korken89/crkbd-shockburst/bottom-plate/production/bom.csv

Designator | Footprint | Quantity | Value | LCSC Part #
_5, _4, _3, _2, | M2_Hole_TH | 5
