korken89/crkbd-shockburst/chocburst/crkbd-shockburst.kicad_pcb

## KiCad design chocburst/crkbd-shockburst.kicad_pcb (2023-09-01)

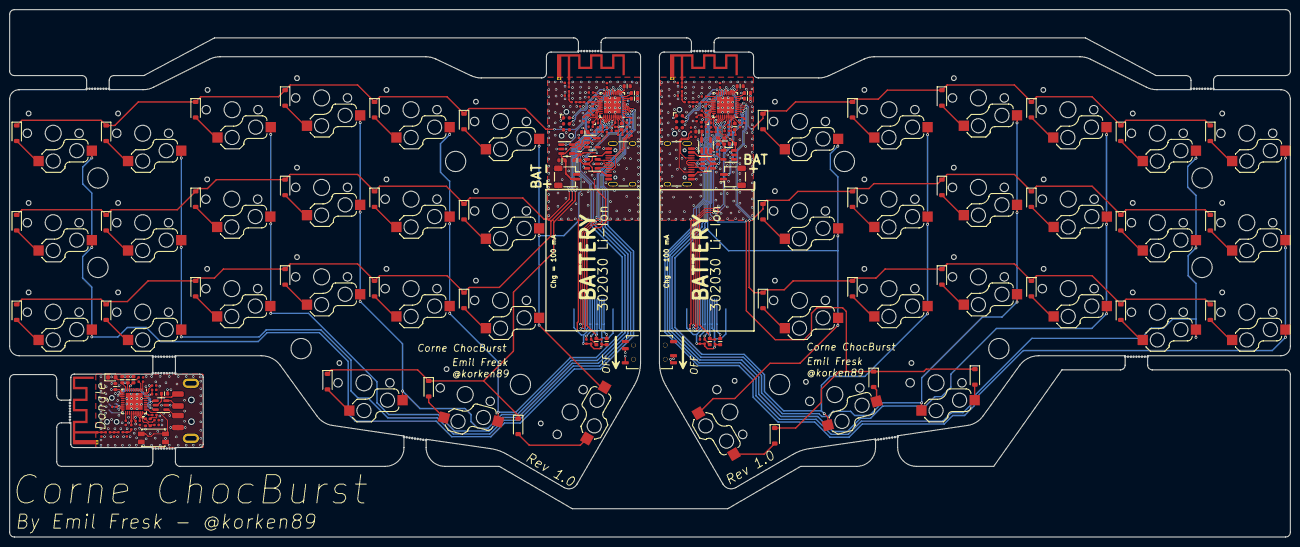
[picture p1: board crkbd-shockburst.kicad_pcb from above]

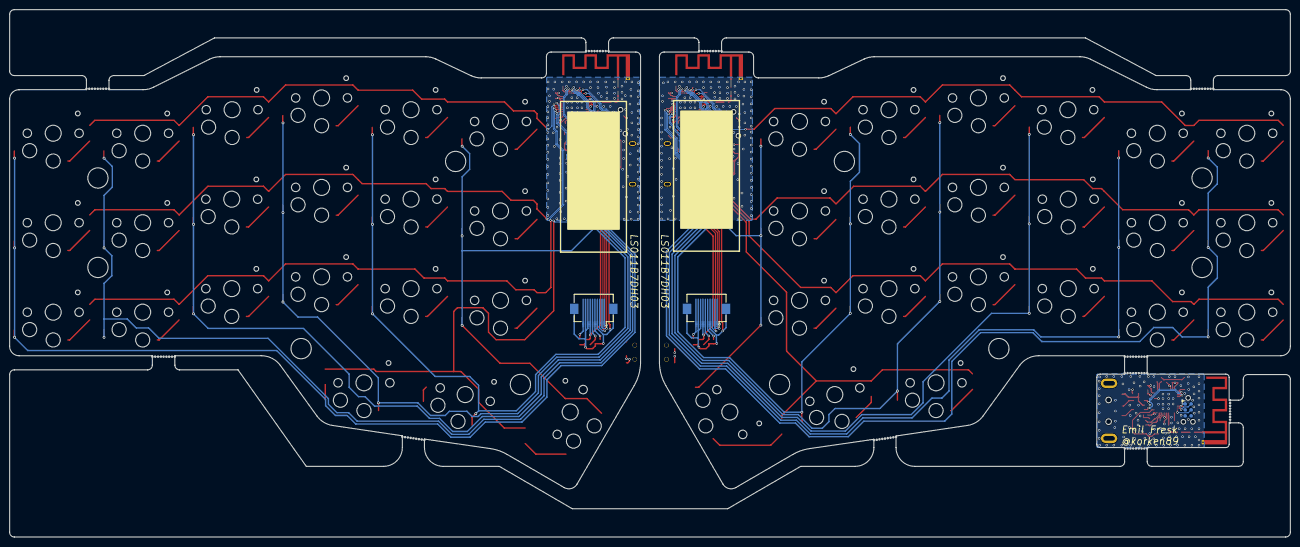
[picture p2: board crkbd-shockburst.kicad_pcb from below]

Board: 4 copper layers, 272.0 x 112.0 mm, 233 parts (3 on the bottom side), 157 nets.

Parts:
Ant101, Ant102, Ant601: antenna; Texas_SWRA117D_2.4GHz_Right
C201, C202, C206, C207, C208, C225, C503, C511, C512, C520, C521, C525, C603, C610, C611, C612: 4.7u; C_0603
C204, C209, C217, C218, C501, C509, C522, C523, C601, C609: 1u; C_0402
C205, C210, C211, C213, C219, C502, C504, C507, C508, C519, C602, C604, C607, C608: 100n; C_0402
C212, C505, C605: 100p; C_0402
C214, C506, C606: 820p; C_0402
C215, C216, C517, C518, C617, C618: 16p; C_0402
C220, C221, C513, C514, C613, C614: C_0402
C222, C515, C615: 1.2p; C_0402
C223, C516, C616: 1p; C_0402
C224, C524: 560p; C_0402
D301, D302, D303, D304, D305, D306, D307, D308, D309, D310, D311, D312, D313, D314, D315, D316, D317, D318, D319, D320, D321, D401, D402, D403, D404, D405, D406, D407, D408, D409, D410, D411, D412, D413, D414, D415, D416, D417, D418, D419, D420, D421: BAT43W; D_SOD-123
D601: RED; D_0603_1608Metric
FB201, FB202, FB203, FB501, FB502, FB503, FB601: FerriteBead_Small; R_0603
H201, H202, H203, H204, H205, H501, H502, H503, H504, H505: MountingHole; MountingHole_4.3mm_M4
J5, J5#2, J5#3, J5#4, J5#5, J5#6, J5#7, J5#8, J5#9, J5#10, J5#11: Breakaway_Tabs
J201, J502: USB_C_Receptacle_USB2.0; USB_C_Receptacle_USB4105
J202, J501, J601: tag-connect-swd; Tag-Connect_TC2030-IDC-NL_2x03_P1.27mm_Vertical
J203, J503: LCD; Hirose_FH12-10S-0.5SH_1x10-1MP_P0.50mm_Horizontal
J204, J504: Conn_01x02_MountingPin; JST_SH_SM02B-SRSS-TB_1x02-1MP_P1.00mm_Horizontal
J602: USB_A; USB_A_1001-011-01101
L201, L502: 10u; R_0603
L202, L501: 47n; R_0402
L203, L503, L603: R_0402
L204, L505, L605: 4.7n; R_0402
L205, L504, L604: 2.2n; R_0402
R101, R601: 1k; R_0402
R201, R202, R502, R503: 1M; R_0402
R203, R204, R504, R505: 5.1k; R_0402
R206, R506: 10k; R_0402
SW101, SW102: SW_SPDT; SSSS810701
SW301, SW302, SW303, SW304, SW305, SW306, SW307, SW308, SW309, SW310, SW311, SW312, SW313, SW314, SW315, SW316, SW317, SW318, SW319, SW320, SW401, SW402, SW403, SW404, SW405, SW406, SW407, SW408, SW409, SW410, SW411, SW412, SW413, SW414, SW415, SW416, SW417, SW418, SW419, SW420: SW_Push; Kailh Choc Hotswap 1U
SW321, SW421: SW_Push; Kailh Choc Hotswap 1.5U
SW601: SW_Push; SW_SPST_EVQP2
U201, U501, U601: nRF52833-QDxx; QFN-40-1EP_5x5mm_P0.4mm_EP3.6x3.6mm
U202, U502, U602: USBLC6-2SC6; SOT-23-6
U203, U504: TPS70630DBVR; SOT-23-5
U204, U503: MCP73832-2-OT; SOT-23-5
Y201, Y501, Y601: 32 MHz; Crystal_4Pin_2.0x1.6mm

Connections:
/Left Keyboard Controller/ANT1: C223.1, L204.2, U201.24 (ANT)
/Left Keyboard Controller/ANT2: C222.1, L204.1, L205.2
/Left Keyboard Controller/ANT3: C221.1, L203.2, L205.1
/Left Keyboard Controller/ANT4: Ant101.1, C220.1, L203.1
/Left Keyboard Controller/CC1: J201.A5 (CC1), R203.2
/Left Keyboard Controller/CC2: J201.B5 (CC2), R204.2
/Left Keyboard Controller/CHG_STAT: U201.17 (P0.20), U204.1 (STAT)
/Left Keyboard Controller/CS: J203.3, U201.36 (AIN7/P0.31)
/Left Keyboard Controller/D+: U201.13 (D+), U202.4 (I/O2)
/Left Keyboard Controller/D-: U201.12 (D-), U202.6 (I/O1)
/Left Keyboard Controller/DATA_IN: J203.2, U201.6 (P1.09)
/Left Keyboard Controller/DCC: L201.2, U201.39 (DCC)
/Left Keyboard Controller/DEC1: C211.1, U201.1 (DEC1)
/Left Keyboard Controller/DEC3: C212.1, U201.27 (DEC3)
/Left Keyboard Controller/DEC4_6: C204.1, C213.1, L202.1, U201.26 (DEC6), U201.38 (DEC4)
/Left Keyboard Controller/DEC5: C214.1, U201.21 (DEC5)
/Left Keyboard Controller/DECUSB: C208.1, U201.11 (DECUSB)
/Left Keyboard Controller/DISP: C224.1, J203.5
/Left Keyboard Controller/KIO0: D301.1 (K), D302.1 (K), D303.1 (K), D304.1 (K), D305.1 (K), D306.1 (K), U201.23 (NFC2/P0.10)
/Left Keyboard Controller/KIO1: D307.1 (K), D308.1 (K), D309.1 (K), D310.1 (K), D311.1 (K), D312.1 (K), U201.15 (P0.17)
/Left Keyboard Controller/KIO2: D313.1 (K), D314.1 (K), D315.1 (K), D316.1 (K), D317.1 (K), D318.1 (K), U201.14 (P0.15)
/Left Keyboard Controller/KIO3: D319.1 (K), D320.1 (K), D321.1 (K), U201.32 (AIN0/P0.02)
/Left Keyboard Controller/KIO4: SW301.1, SW307.1, SW313.1, U201.5 (AIN3/P0.05)
/Left Keyboard Controller/KIO5: SW302.1, SW308.1, SW314.1, U201.4 (AIN2/P0.04)
/Left Keyboard Controller/KIO6: SW303.1, SW309.1, SW315.1, U201.3 (XL2/P0.01)
/Left Keyboard Controller/KIO7: SW304.1, SW310.1, SW316.1, SW319.1, U201.35 (AIN6/P0.30)
/Left Keyboard Controller/KIO8: SW305.1, SW311.1, SW317.1, SW320.1, U201.34 (AIN5/P0.29)
/Left Keyboard Controller/KIO9: SW306.1, SW312.1, SW318.1, SW321.1, U201.33 (AIN4/P0.28)
/Left Keyboard Controller/LEFT: R101.2, U201.22 (NFC1/P0.09)
/Left Keyboard Controller/POWER_EN: SW101.1 (A), U203.3 (EN)
/Left Keyboard Controller/P_D+: J201.A6 (D+), J201.B6 (D+), U202.3 (I/O2)
/Left Keyboard Controller/P_D-: J201.A7 (D-), J201.B7 (D-), U202.1 (I/O1)
/Left Keyboard Controller/SCLK: J203.1, U201.2 (XL1/P0.00)
/Left Keyboard Controller/SWDCLK: J202.4 (SWCLK), U201.20 (SWDCLK)
/Left Keyboard Controller/SWDIO: J202.2 (SWDIO), U201.19 (SWDIO)
/Left Keyboard Controller/VBAT: C202.1, J204.2, R201.1, U203.1 (IN), U204.3 (V_{BAT})
/Left Keyboard Controller/VBAT_MEAS: C219.1, R201.2, R202.1, U201.31 (AIN1/P0.03)
/Left Keyboard Controller/VDD: C205.1, C206.1, C209.1, C210.1, C218.2, C225.1, FB202.1, J202.1 (VCC), J203.7, U201.8 (VDD), U201.9 (VDDH), U201.18 (VDD), U201.30 (VDD), U201.40 (VDD), U203.5 (OUT)
/Left Keyboard Controller/VDDA: C217.2, FB202.2, J203.6
/Left Keyboard Controller/VIN_USB: FB201.1, J201.A4 (VBUS), J201.A9 (VBUS), J201.B4 (VBUS), J201.B9 (VBUS), U202.5 (VBUS)
/Left Keyboard Controller/VSSA: FB203.2, J203.10
/Left Keyboard Controller/VUSB: C201.1, C207.1, FB201.2, U201.10 (VBUS), U204.4 (V_{DD})
/Left Keyboard Controller/XC1: C216.1, U201.28 (XC1), Y201.3
/Left Keyboard Controller/XC2: C215.1, U201.29 (XC2), Y201.1
/Right Keyboard Controller/ANT1: C516.1, L505.2, U501.24 (ANT)
/Right Keyboard Controller/ANT2: C515.1, L504.2, L505.1
/Right Keyboard Controller/ANT3: C514.1, L503.2, L504.1
/Right Keyboard Controller/ANT4: Ant102.1, C513.1, L503.1
/Right Keyboard Controller/CC1: J502.A5 (CC1), R505.2
/Right Keyboard Controller/CC2: J502.B5 (CC2), R504.2
/Right Keyboard Controller/CHG_STAT: U501.17 (P0.20), U503.1 (STAT)
/Right Keyboard Controller/CS: J503.3, U501.36 (AIN7/P0.31)
/Right Keyboard Controller/D+: U501.13 (D+), U502.4 (I/O2)
/Right Keyboard Controller/D-: U501.12 (D-), U502.6 (I/O1)
/Right Keyboard Controller/DATA_IN: J503.2, U501.6 (P1.09)
/Right Keyboard Controller/DCC: L502.2, U501.39 (DCC)
/Right Keyboard Controller/DEC1: C504.1, U501.1 (DEC1)
/Right Keyboard Controller/DEC3: C505.1, U501.27 (DEC3)
/Right Keyboard Controller/DEC4_6: C501.1, C502.1, L501.1, U501.26 (DEC6), U501.38 (DEC4)
/Right Keyboard Controller/DEC5: C506.1, U501.21 (DEC5)
/Right Keyboard Controller/DECUSB: C503.1, U501.11 (DECUSB)
/Right Keyboard Controller/DISP: C524.1, J503.5
/Right Keyboard Controller/KIO0: SW401.1, SW407.1, SW413.1, U501.23 (NFC2/P0.10)
/Right Keyboard Controller/KIO1: SW402.1, SW408.1, SW414.1, U501.15 (P0.17)
/Right Keyboard Controller/KIO2: SW403.1, SW409.1, SW415.1, U501.14 (P0.15)
/Right Keyboard Controller/KIO3: SW404.1, SW410.1, SW416.1, SW419.2, U501.32 (AIN0/P0.02)
/Right Keyboard Controller/KIO4: D401.1 (K), D402.1 (K), D403.1 (K), D404.1 (K), D405.1 (K), D406.1 (K), U501.5 (AIN3/P0.05)
/Right Keyboard Controller/KIO5: D407.1 (K), D408.1 (K), D409.1 (K), D410.1 (K), D411.1 (K), D412.1 (K), U501.4 (AIN2/P0.04)
/Right Keyboard Controller/KIO6: D413.1 (K), D414.1 (K), D415.1 (K), D416.1 (K), D417.1 (K), D418.1 (K), U501.3 (XL2/P0.01)
/Right Keyboard Controller/KIO7: D419.1 (K), D420.1 (K), D421.1 (K), U501.35 (AIN6/P0.30)
/Right Keyboard Controller/KIO8: SW406.1, SW412.1, SW418.1, SW421.2, U501.34 (AIN5/P0.29)
/Right Keyboard Controller/KIO9: SW405.1, SW411.1, SW417.1, SW420.2, U501.33 (AIN4/P0.28)
/Right Keyboard Controller/POWER_EN: SW102.3 (C), U504.3 (EN)
/Right Keyboard Controller/P_D+: J502.A6 (D+), J502.B6 (D+), U502.3 (I/O2)
/Right Keyboard Controller/P_D-: J502.A7 (D-), J502.B7 (D-), U502.1 (I/O1)
/Right Keyboard Controller/SCLK: J503.1, U501.2 (XL1/P0.00)
/Right Keyboard Controller/SWDCLK: J501.4 (SWCLK), U501.20 (SWDCLK)
/Right Keyboard Controller/SWDIO: J501.2 (SWDIO), U501.19 (SWDIO)
/Right Keyboard Controller/VBAT: C521.1, J504.2, R502.1, U503.3 (V_{BAT}), U504.1 (IN)
/Right Keyboard Controller/VBAT_MEAS: C519.1, R502.2, R503.1, U501.31 (AIN1/P0.03)
/Right Keyboard Controller/VDD: C507.1, C508.1, C509.1, C511.1, C523.2, C525.1, FB502.1, J501.1 (VCC), J503.7, U501.8 (VDD), U501.9 (VDDH), U501.18 (VDD), U501.30 (VDD), U501.40 (VDD), U504.5 (OUT)
/Right Keyboard Controller/VDDA: C522.2, FB502.2, J503.6
/Right Keyboard Controller/VIN_USB: FB501.1, J502.A4 (VBUS), J502.A9 (VBUS), J502.B4 (VBUS), J502.B9 (VBUS), U502.5 (VBUS)
/Right Keyboard Controller/VSSA: FB503.2, J503.10
/Right Keyboard Controller/VUSB: C512.1, C520.1, FB501.2, U501.10 (VBUS), U503.4 (V_{DD})
/Right Keyboard Controller/XC1: C517.1, U501.28 (XC1), Y501.3
/Right Keyboard Controller/XC2: C518.1, U501.29 (XC2), Y501.1
/USB Dongle/ANT1: C616.1, L605.2, U601.24 (ANT)
/USB Dongle/ANT2: C615.1, L604.2, L605.1
/USB Dongle/ANT3: C614.1, L603.2, L604.1
/USB Dongle/ANT4: Ant601.1, C613.1, L603.1
/USB Dongle/BUTTON: SW601.1, U601.31 (AIN1/P0.03)
/USB Dongle/D+: U601.13 (D+), U602.6 (I/O1)
/USB Dongle/D-: U601.12 (D-), U602.4 (I/O2)
/USB Dongle/DEC1: C604.1, U601.1 (DEC1)
/USB Dongle/DEC3: C605.1, U601.27 (DEC3)
/USB Dongle/DEC4_6: C601.1, C602.1, U601.26 (DEC6), U601.38 (DEC4)
/USB Dongle/DEC5: C606.1, U601.21 (DEC5)
/USB Dongle/DECUSB: C603.1, U601.11 (DECUSB)
/USB Dongle/LED: R601.2, U601.2 (XL1/P0.00)
/USB Dongle/P_D+: J602.3 (D+), U602.1 (I/O1)
/USB Dongle/P_D-: J602.2 (D-), U602.3 (I/O2)
/USB Dongle/SWDCLK: J601.4 (SWCLK), U601.20 (SWDCLK)
/USB Dongle/SWDIO: J601.2 (SWDIO), U601.19 (SWDIO)
/USB Dongle/VDD: C607.1, C608.1, C609.1, C610.1, J601.1 (VCC), U601.8 (VDD), U601.18 (VDD), U601.30 (VDD), U601.40 (VDD)
/USB Dongle/VIN_USB: FB601.1, J602.1 (VBUS), U602.5 (VBUS)
/USB Dongle/VUSB: C611.1, C612.1, FB601.2, U601.9 (VDDH), U601.10 (VBUS)
/USB Dongle/XC1: C617.1, U601.28 (XC1), Y601.3
/USB Dongle/XC2: C618.1, U601.29 (XC2), Y601.1
GND: Ant101.2, Ant102.2, Ant601.2, C201.2, C202.2, C204.2, C205.2, C206.2, C207.2, C208.2, C209.2, C210.2, C211.2, C212.2, C213.2, C214.2, C215.2, C216.2, C217.1, C218.1, C219.2, C220.2, C221.2, C222.2, C223.2, C224.2, C225.2, C501.2, C502.2, C503.2, C504.2, C505.2, C506.2, C507.2, C508.2, C509.2, C511.2, C512.2, C513.2, C514.2, C515.2, C516.2, C517.2, C518.2, C519.2, C520.2, C521.2, C522.1, C523.1, C524.2, C525.2, C601.2, C602.2, C603.2, C604.2, C605.2, C606.2, C607.2, C608.2, C609.2, C610.2, C611.2, C612.2, C613.2, C614.2, C615.2, C616.2, C617.2, C618.2, D601.1 (K), FB203.1, FB503.1, J201.A1 (GND), J201.A12 (GND), J201.B1 (GND), J201.B12 (GND), J201.S1 (SHIELD), J202.5 (GND), J203.4, J203.8, J203.9, J203.MP (MountPin), J204.1, J204.MP (MountPin), J501.5 (GND), J502.A1 (GND), J502.A12 (GND), J502.B1 (GND), J502.B12 (GND), J502.S1 (SHIELD), J503.4, J503.8, J503.9, J503.MP (MountPin), J504.1, J504.MP (MountPin), J601.5 (GND), J602.4 (GND), J602.5 (Shield), R101.1, R202.2, R203.1, R204.1, R206.1, R503.2, R504.1, R505.1, R506.1, SW101.2 (B), SW102.2 (B), SW601.2, U201.25 (VSS_PA), U201.37 (VSS), U201.41 (VSS), U202.2 (GND), U203.2 (GND), U204.2 (V_{SS}), U501.25 (VSS_PA), U501.37 (VSS), U501.41 (VSS), U502.2 (GND), U503.2 (V_{SS}), U504.2 (GND), U601.25 (VSS_PA), U601.37 (VSS), U601.41 (VSS), U602.2 (GND), Y201.2, Y201.4, Y501.2, Y501.4, Y601.2, Y601.4
unnamed: D301.2 (A), SW301.2
unnamed: D302.2 (A), SW302.2
unnamed: D303.2 (A), SW303.2
unnamed: D304.2 (A), SW304.2
unnamed: D305.2 (A), SW305.2
unnamed: D306.2 (A), SW306.2
unnamed: D307.2 (A), SW307.2
unnamed: D308.2 (A), SW308.2
unnamed: D309.2 (A), SW309.2
unnamed: D310.2 (A), SW310.2
unnamed: D311.2 (A), SW311.2
unnamed: D312.2 (A), SW312.2
unnamed: D313.2 (A), SW313.2
unnamed: D314.2 (A), SW314.2
unnamed: D315.2 (A), SW315.2
unnamed: D316.2 (A), SW316.2
unnamed: D317.2 (A), SW317.2
unnamed: D318.2 (A), SW318.2
unnamed: D319.2 (A), SW319.2
unnamed: D320.2 (A), SW320.2
unnamed: D321.2 (A), SW321.2
unnamed: D401.2 (A), SW401.2
unnamed: D402.2 (A), SW402.2
unnamed: D403.2 (A), SW403.2
unnamed: D404.2 (A), SW404.2
unnamed: D405.2 (A), SW405.2
unnamed: D406.2 (A), SW406.2
unnamed: D407.2 (A), SW407.2
unnamed: D408.2 (A), SW408.2
unnamed: D409.2 (A), SW409.2
unnamed: D410.2 (A), SW410.2
unnamed: D411.2 (A), SW411.2
unnamed: D412.2 (A), SW412.2
unnamed: D413.2 (A), SW413.2
unnamed: D414.2 (A), SW414.2
unnamed: D415.2 (A), SW415.2
unnamed: D416.2 (A), SW416.2
unnamed: D417.2 (A), SW417.2
unnamed: D418.2 (A), SW418.2
unnamed: D419.2 (A), SW419.1
unnamed: D420.2 (A), SW420.1
unnamed: D421.2 (A), SW421.1
unnamed: D601.2 (A), R601.1
unnamed: L201.1, L202.2
unnamed: L501.2, L502.1
unnamed: R206.2, U204.5 (PROG)
unnamed: R506.2, U503.5 (PROG)
