korken89/crkbd-shockburst/firmware/src/radio_protocol.rs

//! # Radio communication
//!
//! ## Registering keyboard to dongle
//!
//! 1. Dongle waits until button held for 3 sec, this will cause it to go into pair mode.
//!        - When in pair mode a periodic "ready to pair" message will be send until 2 keyboard
//!          halves have connected.
//! 2. A keyboard half is then allowed to try to connect by performing an ECDH key exchange.
//!        - A presentation packet is sent from the keyboard to the dongle (ID + right/left)
//!        - Dongle ACKs or rejects due to collision (right/left already paired).
//!        - Public keys are exchanged.
//!        - Shared secret is established and ChaCha8Poly1305 is used for symmetric encryption.
//!        - TODO: Do we need some signature verification?
//!
//! ## Reconnecting keyboard to dongle when already paired
//!
//! 1. A keyboard half is then allowed to try to connect by performing an ECDH key exchange.
//!        - A presentation packet is sent from the keyboard to the dongle (ID + right/left)
//!        - Dongle ACKs or rejects due to wrong id (already paired to different ID).
//!        - Public keys are exchanged.
//!        - Shared secret is established and ChaCha8Poly1305 is used for symmetric encryption.
//!
//! ## After handshake between keyboard and dongle
//!
//! 1. The dongle will be sending "sync" frames at the start of rounds, this is when we are at a known channel.
//!     - All messages in each frame will be frequency hopping according to a known pattern.
//! 2. After sync is received, the keyboard halves will send their state in predetermined slots.
//!     - Each slot will be 1 ms, where even slots is the right half's and odd slots is the left's.
//!     - If there has been a state change in the keyboard input, the new full state will be sent.
//!     - It will be sent, expecting an ACK from the dongle.
//!     - If no ACK is received, the state will be retransmitted until an ACK is received, or
//!       until the keyboard gets a new state.
//!     - If there is no new data for a full frame, the keyboard will send out its state anyways.
//! 3. Keyboards can "disconnect" to save power... somehow...

// use crate::bsp::dongle::DongleLed;
use crate::bsp::Mono;
use crate::radio::{Packet, Radio};
use rtic_monotonics::nrf::timer::fugit::{TimerDurationU64, TimerInstantU64};
use rtic_monotonics::{nrf::timer::*, Monotonic};

/// A channel hopping selector implementation.
pub struct ChannelHopping {
    state: u8,
}

impl ChannelHopping {
    // Randomly generated at: https://www.random.org/sequences/?min=0&max=83&col=1&format=html&rnd=new
    // and slightly modified to make adjacent hops not be adjacent channels.
    //
    // This will use all channels in the 2.400 - 2.483 GHz band twice.
    const CHANNEL_HOPPING_SEQUENCE: [u8; 167] = [
        5, 38, 24, 36, 15, 26, 51, 7, 63, 82, 11, 40, 65, 21, 80, 81, 32, 74, 50, 48, 70, 42, 76,
        8, 20, 75, 53, 77, 6, 79, 46, 71, 62, 14, 29, 19, 2, 17, 59, 35, 83, 56, 34, 61, 22, 66,
        54, 67, 44, 78, 52, 68, 4, 45, 27, 31, 18, 0, 60, 43, 12, 55, 13, 9, 58, 16, 47, 10, 25,
        72, 3, 33, 69, 1, 39, 57, 28, 73, 37, 64, 49, 23, 41, 30, // first round (0-83)
        11, 23, 66, 0, 21, 74, 52, 28, 45, 14, 65, 18, 30, 43, 57, 71, 31, 63, 2, 50, 1, 42, 10,
        72, 9, 76, 33, 64, 54, 49, 62, 15, 44, 25, 51, 40, 58, 68, 37, 67, 22, 47, 19, 55, 13, 36,
        17, 56, 27, 46, 70, 20, 78, 24, 79, 59, 39, 81, 8, 34, 82, 41, 69, 38, 26, 3, 75, 35, 60,
        77, 7, 48, 4, 32, 5, 80, 53, 6, 61, 29, 12, 83, 16, // 73, // second round (0-83)
    ];

    /// Create a new channel hopping selector.
    pub const fn new() -> Self {
        Self { state: 0 }
    }

    /// Get the current channel.
    pub fn current_channel(&self) -> u8 {
        Self::CHANNEL_HOPPING_SEQUENCE[self.state as usize]
    }

    /// Move to the next channel.
    pub fn next_channel(&mut self) {
        self.state = (self.state + 1) % Self::CHANNEL_HOPPING_SEQUENCE.len() as u8;
    }

    /// Check if the current channel is the initial state.
    pub fn is_initial_state(&self) -> bool {
        self.state == 0
    }

    /// Reset to initial state.
    pub fn reset(&mut self) {
        self.state = 0;
    }

    /// Return the current timeslot.
    pub fn state(&self) -> u8 {
        self.state
    }
}

/// The size of an slot in the protocol in microseconds (empirically this needs to be > 600 us)>
pub const SLOT_SIZE: TimerDurationU64<1_000_000> = TimerDurationU64::micros(1_000);

/// Main runner for the dongle's radio communication.
pub async fn dongle_radio_runner(mut radio: Radio) -> ! {
    // 1. Pairing stage

    // 2. Connected stage

    let mut packet = Packet::new();
    let mut slot_start_time = Mono::now() + 200.millis();
    let mut channel_hopping = ChannelHopping::new();

    loop {
        //
        // 1. Send the sync packet at the desired time.
        //
        Mono::delay_until(slot_start_time).await;

        // defmt::info!(
        //     "Trying to send on channel {} ({}) at {}...",
        //     channel_hopping.current_channel(),
        //     channel_hopping.state,
        //     slot_start_time
        // );

        radio.set_freqeuency(channel_hopping.current_channel());
        // TODO: Actually send something as sync
        packet.copy_from_slice(&[0, 1, 2, 3, 4, 5, 6, 7, 8, 9]);
        let sync_timestamp = radio.send_no_cca(&mut packet).await.0;

        //
        // 2. Receive and channel hop, look for keyboard halves responses.
        //
        channel_hopping.next_channel();
        slot_start_time += SLOT_SIZE;

        let mut correct_rxes = 0;
        let mut missed_rxes = 0;

        while !channel_hopping.is_initial_state() {
            radio.set_freqeuency(channel_hopping.current_channel());

            // Look for packets, stop receiving a little before the next round.
            match Mono::timeout_at(
                slot_start_time + SLOT_SIZE - 200.micros(),
                radio.recv(&mut packet),
            )
            .await
            {
                Ok(ts) => {
                    if let Ok((ts, rssi)) = ts {
                        // defmt::debug!(
                        //     "Got data, channel {} ({}): {}",
                        //     channel_hopping.state(),
                        //     rssi,
                        //     *packet,
                        // );
                        correct_rxes += 1;

                        // TODO: Send ack.
                        packet.copy_from_slice(&[10, 11, 12, 13, 14, 15, 16, 17, 18, 19]);
                        radio.send_no_cca(&mut packet).await;
                    }
                }
                Err(_timeout) => {
                    missed_rxes += 1;
                    //defmt::warn!("No data, channel {}", channel_hopping.state())
                }
            };

            channel_hopping.next_channel();
            slot_start_time += SLOT_SIZE;
        }

        defmt::info!(
            "This master frame got {} successful RXes and {} missed",
            correct_rxes,
            missed_rxes
        );
    }
}

#[derive(Copy, Clone, Debug, defmt::Format)]
enum KeyboardRadioState {
    LookingForSync,
    Synchronized {
        sync_time: TimerInstantU64<1_000_000>,
        slot_start_time: TimerInstantU64<1_000_000>,
    },
}

/// Main runner for a keyboard half's radio communication.
pub async fn keyboard_radio_runner(mut radio: Radio, is_right_half: bool) -> ! {
    let mut packet = Packet::new();
    let mut channel_hopping = ChannelHopping::new();

    let mut state = KeyboardRadioState::LookingForSync;

    let mut i = 0;

    // RX code:
    loop {
        // if led.is_set_high() {
        //     led.set_low();
        // } else {
        //     led.set_high();
        // }

        match state {
            KeyboardRadioState::LookingForSync => {
                defmt::info!("Got {} acks last round", i);
                i = 0;

                channel_hopping.reset();
                radio.set_freqeuency(channel_hopping.current_channel());
                let (timestamp, rssi) = if let Ok(v) = radio.recv(&mut packet).await {
                    v
                } else {
                    defmt::info!("Radio receive error");
                    continue;
                };

                // defmt::info!(
                //     "Radio receive ts {}, rssi {}, packet: {}",
                //     timestamp,
                //     rssi,
                //     *packet
                // );

                if channel_hopping.is_initial_state() && &*packet == [0, 1, 2, 3, 4, 5, 6, 7, 8, 9]
                {
                    defmt::info!("Sync found at {}", timestamp.0);

                    // Hack to get RX timestamp in mono time...
                    let now = TimerInstantU64::from_ticks(
                        Mono::now().ticks() & 0xffff_ffff_0000_0000 | timestamp.0.ticks() as u64,
                    );

                    if is_right_half {
                        // Right half gets the odd slots.
                        channel_hopping.next_channel();
                        state = KeyboardRadioState::Synchronized {
                            sync_time: now,
                            slot_start_time: now + SLOT_SIZE,
                        };
                    } else {
                        // Left half gets the even slots.
                        channel_hopping.next_channel();
                        channel_hopping.next_channel();
                        state = KeyboardRadioState::Synchronized {
                            sync_time: now,
                            slot_start_time: now + 2 * SLOT_SIZE,
                        };
                    }
                }
            }
            KeyboardRadioState::Synchronized {
                sync_time,
                mut slot_start_time,
            } => {
                loop {
                    radio.set_freqeuency(channel_hopping.current_channel());

                    // TODO: Send data and wait for ack.
                    packet.copy_from_slice(&[channel_hopping.state()]);

                    Mono::delay_until(slot_start_time).await;
                    let timestamp = radio.send_no_cca(&mut packet).await;

                    // defmt::info!(
                    //     "Sent at {}, sync = {}, diff = {} ms",
                    //     timestamp.0,
                    //     slot_start_time,
                    //     (slot_start_time - sync_time).to_millis(),
                    // );

                    // Look for ACK.
                    match Mono::timeout_at(slot_start_time + 1800.micros(), radio.recv(&mut packet))
                        .await
                    {
                        Ok(_) => {
                            i += 1;
                            // defmt::info!("Got ack, channel {}", channel_hopping.current_channel());
                        }
                        Err(_timeout) => {
                            // defmt::warn!("No ack, channel {}", channel_hopping.current_channel(),)
                        }
                    };

                    // Jump 2 channels as every keyboard half gets half of the slots.
                    slot_start_time += SLOT_SIZE;
                    channel_hopping.next_channel();
                    if channel_hopping.is_initial_state() {
                        break;
                    }

                    slot_start_time += SLOT_SIZE;
                    channel_hopping.next_channel();
                    if channel_hopping.is_initial_state() {
                        break;
                    }
                }

                // TODO: Check for sync instead of dropping back to "initial sync search", that
                // should only happen if we've lost sync for multiple frames.
                state = KeyboardRadioState::LookingForSync;
            }
        }
    }
}
