korken89/crkbd-shockburst/(commit log)

2023-08-06 Initial project
    [crkbd-shockburst.kicad_pcb, crkbd-shockburst.kicad_sch]
2023-08-09 Add top/bottom plate
    [bottom-plate.kicad_pcb, top-plate.kicad_pcb]
2023-08-09 Production files
    [bom.csv, designators.csv, positions.csv]
2023-08-12 Make hotswap sockets mountable by JLCPCB
    [crkbd-shockburst.kicad_pcb, crkbd-shockburst.kicad_sch, keyboard_half.kicad_sch, left_switches.kicad_sch, right_switches.kicad_sch, usb_dongle.kicad_sch]
2023-08-13 Testing memory pixel display
    [crkbd-shockburst.kicad_pcb]
2023-08-19 Finished routing, passing DRC
    [crkbd-shockburst.kicad_pcb]
2023-08-20 Add power switch
    [crkbd-shockburst.kicad_pcb, crkbd-shockburst.kicad_sch, keyboard_half.kicad_sch]
2023-08-22 Reorganization, added dongle firmware folder
    [bom.csv, crkbd-shockburst.kicad_pcb, crkbd-shockburst.kicad_sch, designators.csv, keyboard_half.kicad_sch, left_switches.kicad_sch, positions.csv, right_switches.kicad_sch]
2023-08-26 Some small fixes for battery connector
    [bom.csv, crkbd-shockburst.kicad_pcb, designators.csv, keyboard_half.kicad_sch, positions.csv]
2023-09-01 Fix radio sometimes panicing
    [radio.rs]
2023-09-01 Add Chocolate switch version
    [bom.csv, crkbd-shockburst.kicad_pcb, crkbd-shockburst.kicad_sch, designators.csv, keyboard_half.kicad_sch, left_switches.kicad_sch, positions.csv, right_switches.kicad_sch]
2023-09-17 Update top plate
    [top-plate.kicad_pcb]
2023-10-09 Make sure RX is of before switching channel frequency
2023-10-11 Abstract slot size
2023-10-18 Fix time estimates for keygen and sign/verify
    [dongle.rs]
